themrsung/YM60JIS-trilingual-macos/doc/pcb-compare/img/pcb_bottom_after.png

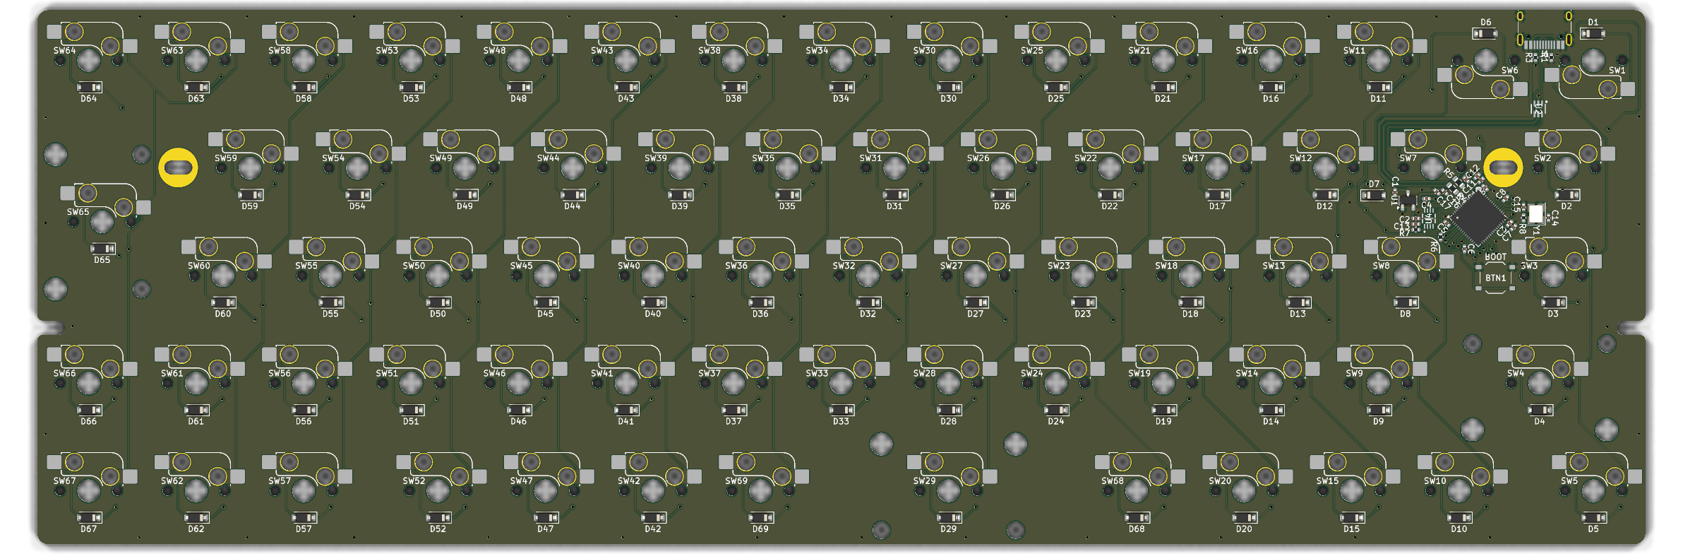
doc/pcb-compare/img/pcb_bottom_after.png
