themrsung/YM60JIS-trilingual-macos/doc/pcb-compare/img/pcb_top_before.png

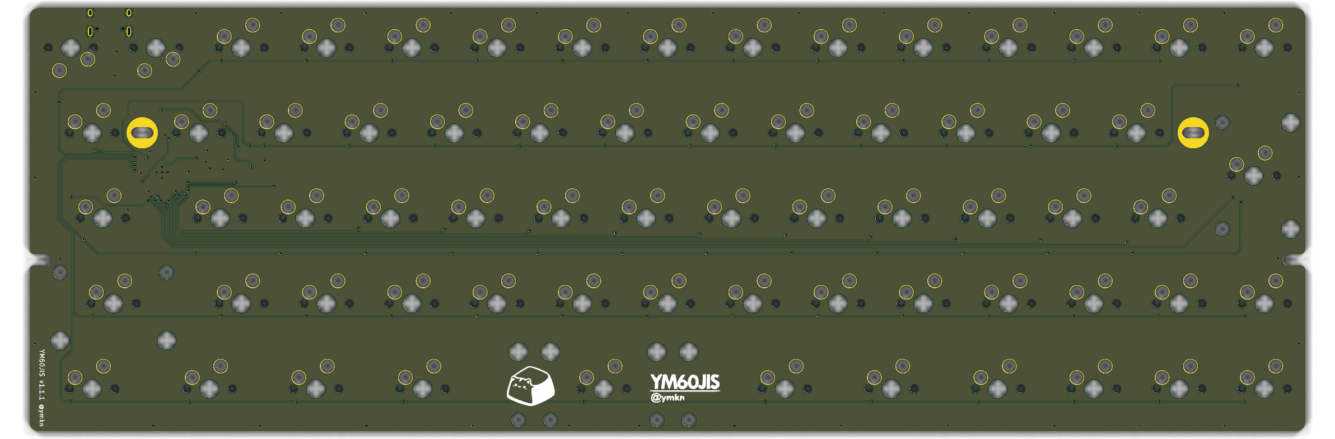
doc/pcb-compare/img/pcb_top_before.png
