themrsung/YM60JIS-trilingual-macos/KiCAD/PCB/production/YM60JIS_PCB_Trilingual_v1.1.2/bom.csv

Designator | Footprint | Quantity | Value | LCSC Part #
BTN1 | SW_Push_1P1T_XKB_TS-1187A | 1 | TS-1187A-B-A-B | C318884
C1, C2 | C_0402_1005Metric | 2 | 10uF | C15525
C11, C12 | C_0402_1005Metric | 2 | 1uF | C52923
C14, C15 | C_0402_1005Metric | 2 | 20pF | C1554
C3, C4, C5, C6, C7, C8, C9, C10, C13, C16, C17 | C_0402_1005Metric | 11 | 100nF | C1525
D1, D2, D3, D4, D5, D6, D7, D8, D9, D10, D11, D12, D13, D14, D15, D16, D17, D18, D19, D20, D21, D22, D23, D24, D25, D26, D27, D28, D29, D30, D31, D32, D33, D34, D35, D36, D37, D38, D39, D40, D41, D42, D43, D44, D45, D46, D47, D48, D49, D50, D51, D52, D53, D54, D55, D56, D57, D58, D59, D60, D61, D62, D63, D64, D65, D66, D67, D68, D69 | D_SOD-123 | 69 | 1N4148W | C81598
J1 | USB_C_Receptacle_HRO_TYPE-C-31-M-12 | 1 | TYPE-C-31-M-12 | C165948
R1, R3 | R_0402_1005Metric | 2 | 5.1K | C25905
R4, R5 | R_0603_1608Metric | 2 | 27 | C25190
R6 | R_0402_1005Metric | 1 | 1KΩ | C11702
R7 | R_0402_1005Metric | 1 | 10kΩ | C25744
R8 | R_0402_1005Metric | 1 | 1K | C11702
SW1, SW4, SW5, SW6, SW7, SW8, SW9, SW10, SW11, SW12, SW13, SW14, SW15, SW16, SW17, SW18, SW19, SW20, SW21, SW22, SW23, SW24, SW25, SW26, SW27, SW28, SW30, SW31, SW32, SW33, SW34, SW35, SW36, SW37, SW38, SW39, SW40, SW41, SW42, SW43, SW44, SW45, SW46, SW47, SW48, SW49, SW50, SW51, SW52, SW53, SW54, SW55, SW56, SW57, SW58, SW59, SW60, SW61, SW62, SW66, SW67, SW68, SW69 | SW_MX_HS_CPG151101S11_1u | 63 | SW_Push | C41430893
SW2 | SW_MX_HS_CPG151101S11_1.5u | 1 | SW_Push | C41430893
SW29 | SW_MX_HS_CPG151101S11_1u | 1 | Space | C41430893
SW3 | SW_MX_HS_CPG151101S11_1.75u | 1 | SW_Push | C41430893
SW63 | SW_MX_HS_CPG151101S11_1u | 1 | Yen | C41430893
SW64 | SW_MX_HS_CPG151101S11_1u | 1 | Backspace | C41430893
SW65 | SW_MX_HS_CPG151101S11_1u | 1 | ISOEnter | C41430893
U1 | SOT-23-3 | 1 | XC6206P332MR | C5446
U2 | SOT-363-6_2P2X1P35_ONS | 1 | SMF05CT1G | C15879
U3 | QFN-56-1EP_7x7mm_P0.4mm_EP3.2x3.2mm | 1 | RP2040 | C2040
U4 | W25Q16JVUXIQ_WIN | 1 | W25Q16JVUXIQ | C2843335
Y1 | Crystal_SMD_3225-4Pin_3.2x2.5mm | 1 | X322512MSB4SI | C9002
