themrsung/YM60JIS-trilingual-macos/(commit log)

2026-10-10 Trilingual fork initial commit
    Rework the bottom row into an HHKB-style macOS layout:
    Fn, Lang3, Option, Command, 英数, Space (2.5u), かな, Command, Option, Fn,
    with 0.25u gaps before Lang3 and before the arrow keys.
    - Firmware: new row 4 layout using matrix (4,4) and (4,7); HHKB mapping
    with Control on Caps and the HHKB Fn layer; Lang3 sends KC_GRV.
    Fix row 3 x offsets in keyboard.json.
    - Vial: update the bottom row definition.
    - Schematic: add SW68/D68 (COL4) and SW69/D69 (COL7) on ROW4.
    - Docs: rewrite README and build guide in English for the new layout;
    add base and Fn layer diagrams.
    PCB and plate are not yet updated.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
    [YM60JIS_PCB.kicad_sch]
2026-10-10 Rework PCB and plate for the HHKB-style bottom row (v1.1.2)
    - Schematic: switch footprints for the former 1.25u/1.5u bottom-row keys
    are now 1u.
    - PCB: move all bottom-row switches and diodes to the new 2.5u-spacebar
    layout, add SW68/D68 (COL4) and SW69/D69 (COL7), replace the 2.75u/3u
    spacebar stabilizers with a 2u stabilizer, and reroute row 4. Move a
    GND via off the new stabilizer hole and the text logo off the かな
    switch. DRC: 0 unconnected pads, no new errors vs v1.1.1.
    - Plate: switch and stabilizer cutouts for the new bottom row.
    - Version label: "YM60JIS Trilingual v1.1.2 @ymkn & @themrsung".
    - PCB and plate are now saved in KiCAD 10 format.
    - Add before/after 3D render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
    [YM60JIS_PCB.kicad_pcb, YM60JIS_PCB.kicad_sch, YM60JIS_Plate.kicad_pcb]
2026-10-10 Add fabrication files for Trilingual v1.1.2 PCB and plate
    PCB: Gerber/Excellon zip (same 13-file set as v1.1.2), JLCPCB BOM and
    CPL (with and without hot-swap sockets), designators and IPC-D-356
    netlist. CPL rotations are carried over from the assembled v1.1.2 CPL;
    SW68/SW69/D68/D69 use the rotations of identical parts.
    Plate: Gerber/Excellon zip.
    Exported with KiCad 10.0.6; oval holes use route mode as in v1.1.2.
    Checked against the v1.1.2 production set: all drill/copper changes
    are confined to the bottom row, PCB connectivity matches the schematic,
    and the matrix matches the firmware.
    [YM60JIS_PCB-B_Cu.gbl, YM60JIS_PCB-B_Mask.gbs, YM60JIS_PCB-B_Paste.gbp, YM60JIS_PCB-B_Silkscreen.gbo, YM60JIS_PCB-Edge_Cuts.gm1, YM60JIS_PCB-F_Cu.gtl, YM60JIS_PCB-F_Mask.gts, YM60JIS_PCB-F_Paste.gtp]
